axelaberg91/ClockSync-Evolved/hardware/coil/coil-75mm-integrated-holder.3mf

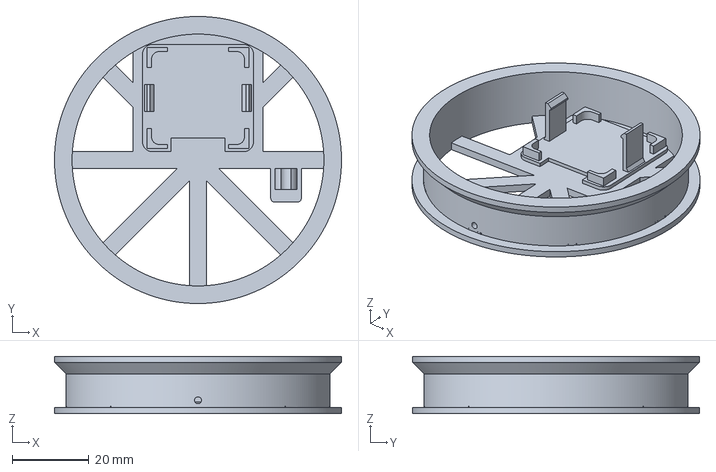
[picture p2: CAD file, 2026-10-17]
hardware/coil/coil-75mm-integrated-holder.3mf
75.0 x 75.0 x 15.0 mm
