axelaberg91/ClockSync-Evolved/hardware/connector/dupont-housing-clip.3mf

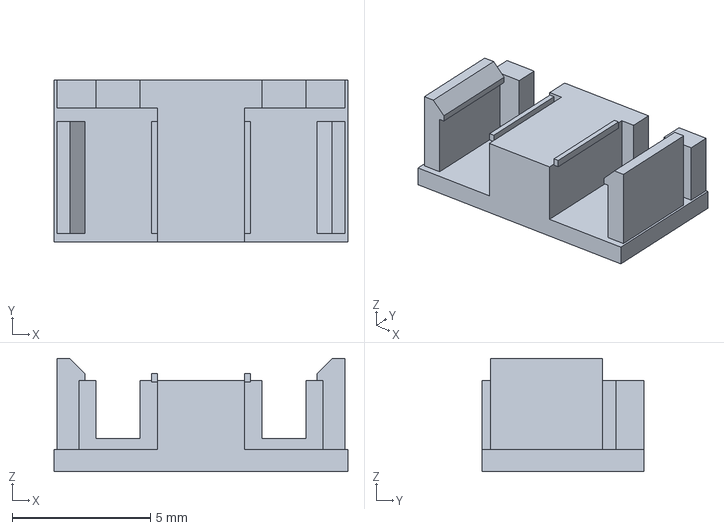
[picture p3: CAD file, 2026-10-17]
hardware/connector/dupont-housing-clip.3mf
10.6 x 5.85 x 4.10 mm
