axelaberg91/ClockSync-Evolved/hardware/print/print-both.3mf

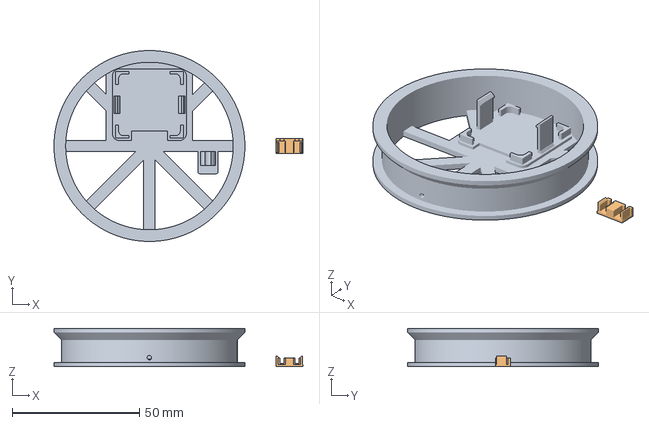
[picture p4: CAD file, 2026-10-17]
hardware/print/print-both.3mf
97.8 x 75.0 x 15.0 mm
Coil with integrated Atom holder
Rear clip for complete Dupont housings
