axelaberg91/ClockSync-Evolved/hardware/coil/coil-75mm-integrated-holder.scad

// SPDX-License-Identifier: CC-BY-NC-4.0
// Original design by axelaberg91; see ../LICENSE.md.
// ATOM Lite / clocksync coil former v6 integrated. Units: mm.
outer_d=75;
core_d=69;
core_wall=1.6;
usable_winding_height=8.8;
lower_flange=1.6;
flare_height=(outer_d-core_d)/2;
upper_flange=1.6;
height=lower_flange+usable_winding_height+flare_height+upper_flange;
pad=34;
pad_corner_r=2;
pad_height=2;
recess_depth=0.6;
recess_clearance=0.15;
pad_offset_y=16.2;
spoke_width=4.5;
spoke_thickness=2;
lead_hole_d=1.8;
resistor_x=23;
resistor_y=-5;
resistor_angle=90;
resistor_pocket_d=3.4;
resistor_mouth=2.5;
resistor_wall=1.2;
$fn=256;
module rounded_pad(){
 linear_extrude(pad_height) offset(r=pad_corner_r,$fn=32)
  square([pad-2*pad_corner_r,pad-2*pad_corner_r],center=true);
}
module ring(){
 difference(){
  union(){
   cylinder(h=height,d=core_d);
   cylinder(h=lower_flange,d=outer_d);
   translate([0,0,lower_flange+usable_winding_height])
    cylinder(h=flare_height,d1=core_d,d2=outer_d);
   translate([0,0,height-upper_flange]) cylinder(h=upper_flange,d=outer_d);
  }
  translate([0,0,-0.1]) cylinder(h=height+0.2,d=core_d-2*core_wall);
 }
}
module placement_recess(){
 translate([0,pad_offset_y,pad_height-recess_depth]) difference(){
  linear_extrude(recess_depth+0.1) offset(r=2.5+recess_clearance,$fn=32)
   square([24,23],center=true);
  translate([-7+recess_clearance,-14.25,-0.1]) cube([14-2*recess_clearance,3.7,recess_depth+0.3]);
 }
}
module resistor_clip(){
 translate([resistor_x,resistor_y,0]) rotate([0,0,resistor_angle]){
  linear_extrude(2) offset(r=1,$fn=32) square([10,6],center=true);
  difference(){
   translate([-2.75,0,4.2]) rotate([0,90,0]) cylinder(h=5.5,r=resistor_pocket_d/2+resistor_wall,$fn=96);
   translate([-2.85,0,4.2]) rotate([0,90,0]) cylinder(h=5.7,d=resistor_pocket_d,$fn=96);
   translate([-3,-resistor_mouth/2,4.2]) cube([6,resistor_mouth,3.8]);
  }
 }
}
union(){
 difference(){
 union(){
  ring();intersection(){translate([0,pad_offset_y,0]) rounded_pad();cylinder(h=pad_height,d=core_d-2*core_wall);}
  resistor_clip();
  for(a=[0,45,90,135]) rotate([0,0,a])
   translate([-core_d/2,-spoke_width/2,0]) cube([core_d,spoke_width,spoke_thickness]);
 }
 translate([0,-(core_d/2-6),3.5])
  rotate([90,0,0]) cylinder(h=11,d=lead_hole_d,$fn=48);

}

translate([0,16.2,1.4]) integrated_atom_holder();
}
module integrated_atom_holder(){
// Dimensions in mm. Generated from build_atom_parts.py.
difference(){union(){union(){union(){union(){union(){union(){union(){union(){union(){union(){union(){union(){union(){union(){union(){union(){union(){union(){union(){union(){union(){union(){union(){translate([-12.0,-14.0,0]) cube([24.0, 28.0, 1.6]);translate([-14.5,-11.5,0]) cube([29.0, 23.0, 1.6]);}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
}
