axelaberg91/ClockSync-Evolved/hardware/connector/dupont-housing-clip.scad

// SPDX-License-Identifier: CC-BY-NC-4.0
// Original design by axelaberg91; see ../LICENSE.md.
// Units: mm. Nominal Dupont 2.54 x 2.54 x 14 mm; pin centers 6 mm.
// No printed material ahead of y=9.5. Retains original complete housings.
union(){union(){union(){union(){union(){union(){translate([-5.32,9.5,0]) cube([10.64,5.85,0.8]);translate([-1.58,9.5,0.7]) cube([3.16,4.85,2.5999999999999996]);}translate([0,13.85,0]) rotate([90,0,0]) linear_extrude(4.049999999999999) polygon([[-4.42, 3.3], [-4.2, 3.3], [-4.2, 3.55], [-4.75, 4.1], [-5.22, 4.1], [-5.22, 0.7], [-4.42, 0.7]]);}translate([-1.8,9.8,3.25]) cube([0.21999999999999997,4.049999999999999,0.2999999999999998]);}translate([0,13.85,0]) rotate([90,0,0]) linear_extrude(4.049999999999999) polygon([[4.42, 0.7], [5.22, 0.7], [5.22, 4.1], [4.75, 4.1], [4.2, 3.55], [4.2, 3.3], [4.42, 3.3]]);}translate([1.58,9.8,3.25]) cube([0.21999999999999997,4.049999999999999,0.2999999999999998]);}difference(){difference(){translate([-5.22,14.35,0.7]) cube([10.44,1.0,2.5999999999999996]);translate([-3.8,14.25,1.2]) cube([1.5999999999999996,1.1999999999999993,3.0]);}translate([2.2,14.25,1.2]) cube([1.5999999999999996,1.1999999999999993,3.0]);}}
