axelaberg91/ClockSync-Evolved/(list of files, cad)

Other CAD files:
hardware/coil/coil-75mm-integrated-holder.stl
hardware/connector/dupont-housing-clip.stl
