axelaberg91/ClockSync-Evolved/(commit log)

2026-10-17 Add tested Atom Lite coil build, printable parts and assembly guide
    [coil-75mm-integrated-holder.3mf, coil-75mm-integrated-holder.scad, coil-75mm-integrated-holder.stl, dupont-housing-clip.3mf, dupont-housing-clip.scad, dupont-housing-clip.stl, print-both.3mf]
2026-10-17 Simplify assembly instructions and illustrate the coil wiring
2026-10-17 Show both resistor leads in red in the assembly illustration
2026-10-17 License original contributions and print assets under CC BY-NC 4.0
    [coil-75mm-integrated-holder.scad, dupont-housing-clip.scad]
2026-10-18 Clarify Atom Lite target and ESP32 DevKit porting steps
